gastonravindias/open-educational-ecg-data-logger/figures/Figure2_Revised_Hardware.png

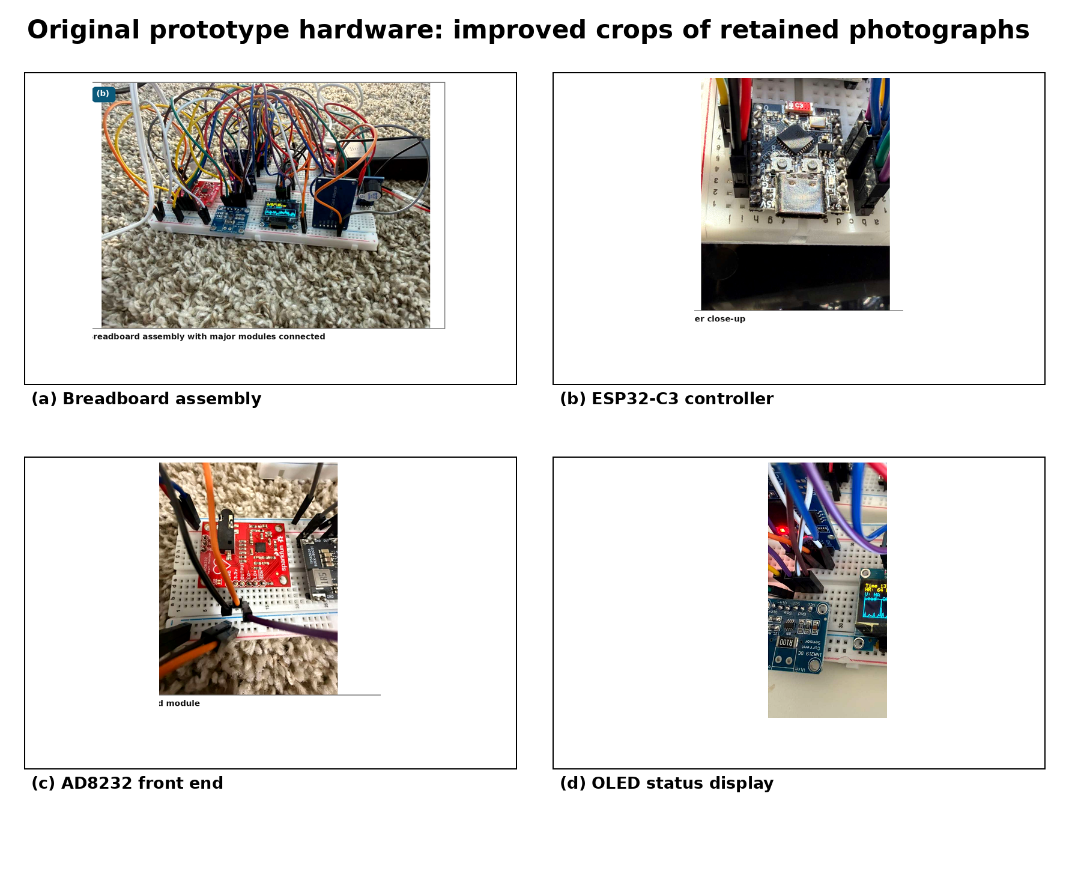
figures/Figure2_Revised_Hardware.png
