gastonravindias/open-educational-ecg-data-logger/media/serial_plotter_outputs.png

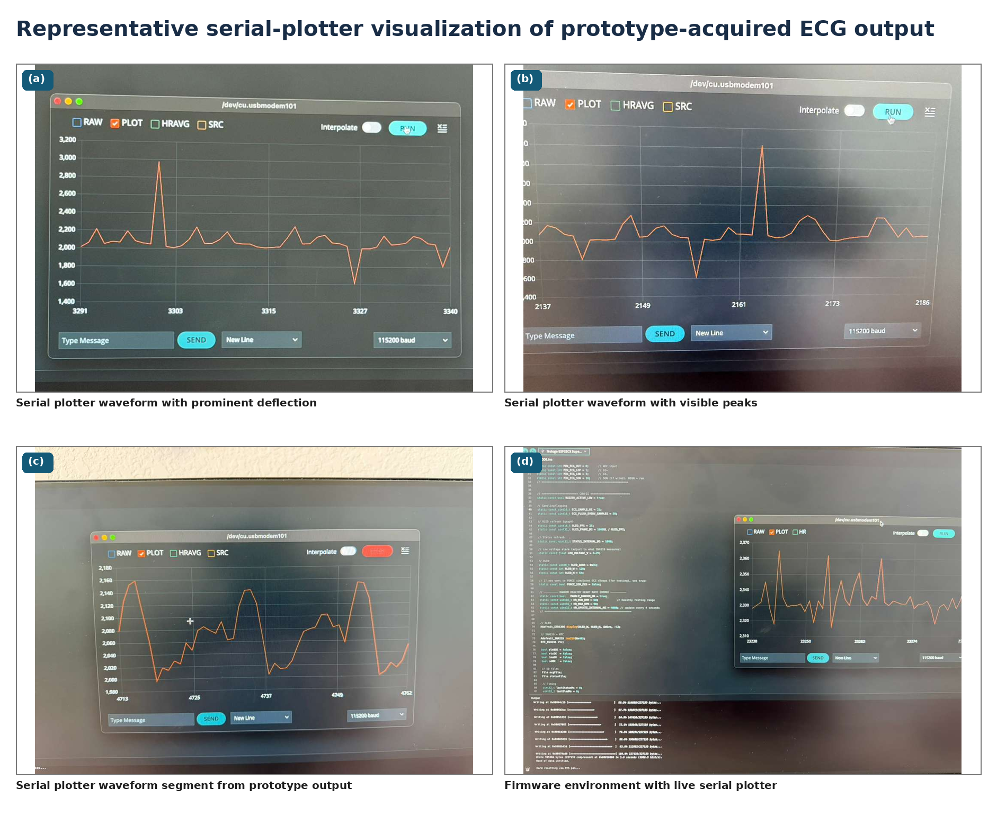
media/serial_plotter_outputs.png
