gastonravindias/open-educational-ecg-data-logger/figures/Figure1_Revised_Architecture.png

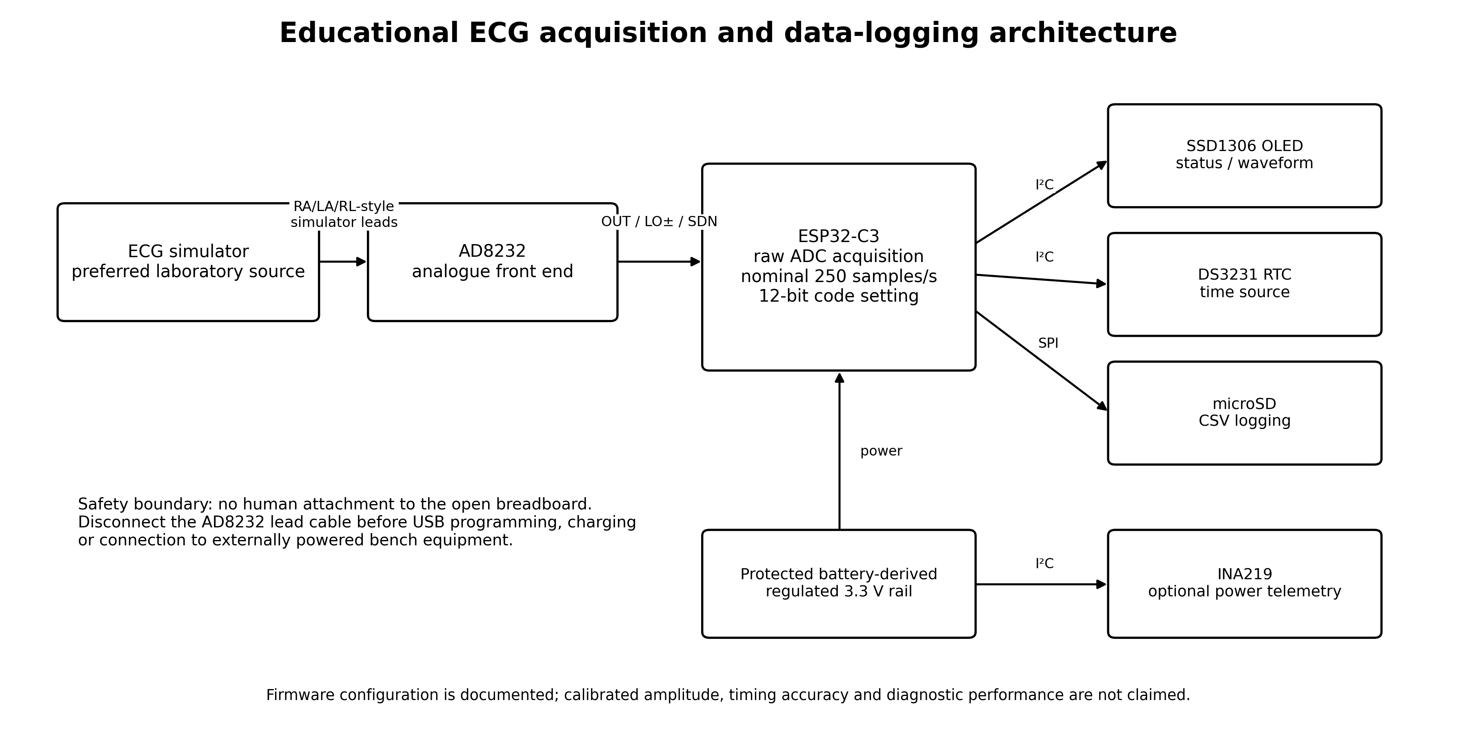
figures/Figure1_Revised_Architecture.png
