gastonravindias/open-educational-ecg-data-logger/figures/Figure3_Full_Connection_Diagram.png

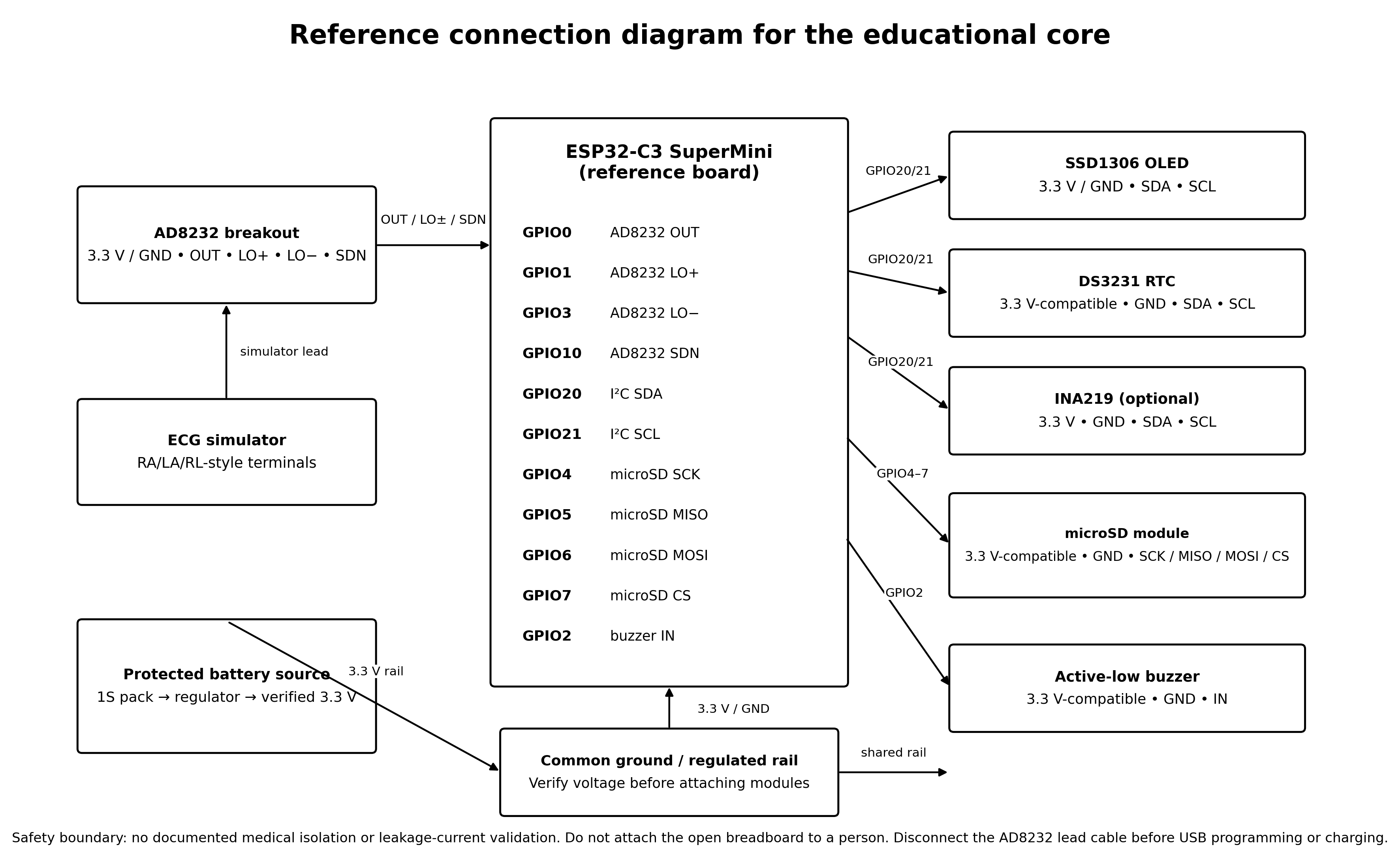
figures/Figure3_Full_Connection_Diagram.png
