gastonravindias/open-educational-ecg-data-logger/figures/Figure4_Revised_Waveform_Evidence.png

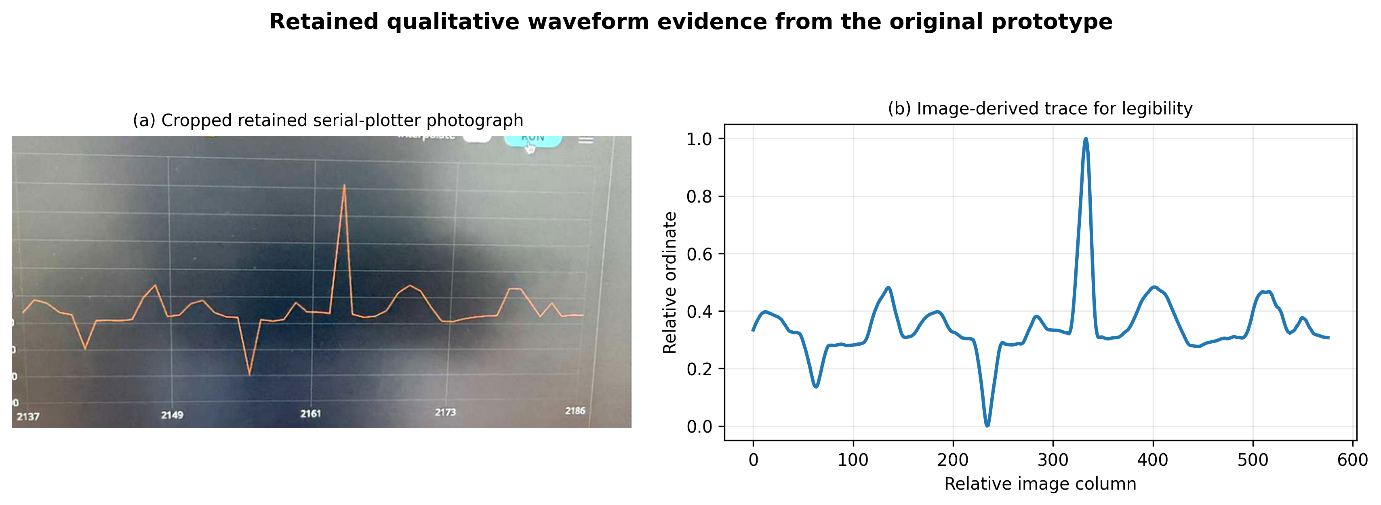
figures/Figure4_Revised_Waveform_Evidence.png
