gastonravindias/open-educational-ecg-data-logger/media/functional_evidence.png

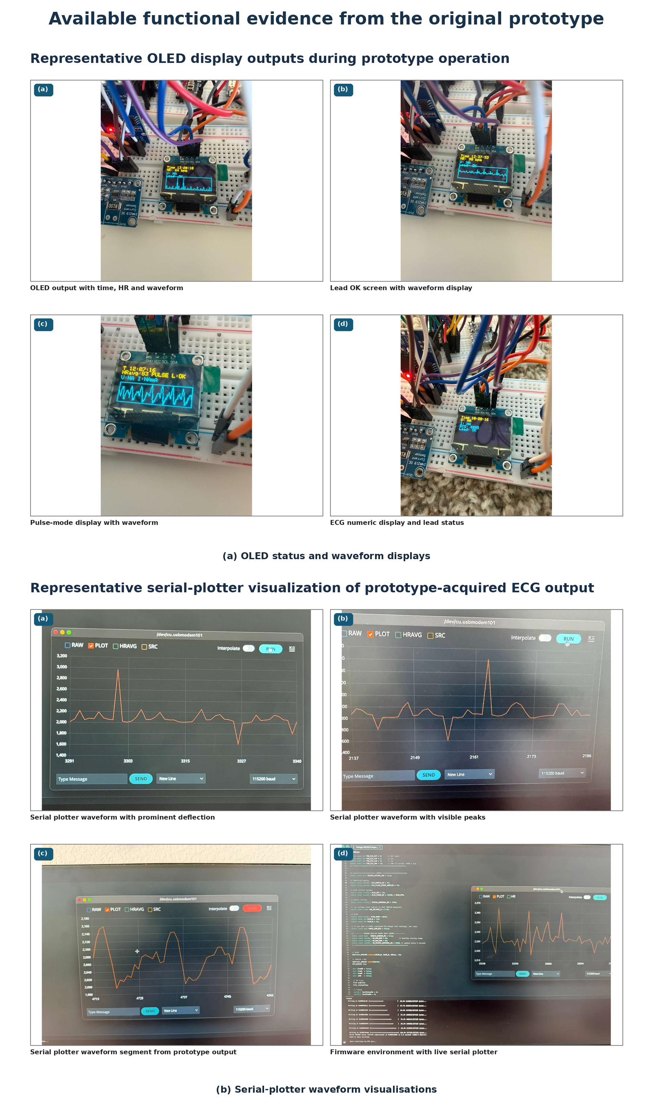
media/functional_evidence.png
