gastonravindias/open-educational-ecg-data-logger/REVIEW_REVISION_CHANGELOG.md

# Review Revision Changelog

## Reviewer B
Full connection/build guide; staged diagnostics; explicit ADC calibration boundary; simulator data-logging exercise; missing historical raw waveform data declared rather than reconstructed.

## Reviewer D
Comparison with representative systems; intended-user/prerequisite/supervision definition; concrete teaching scenarios; expanded BOM and power-source specification; solar removed from educational core; stronger safety; redrawn/improved figures.

## Reviewer E
FAIR/Data Accessibility statement; repository navigation; dependency/version documentation; ESP32-C3 raw-count and count-to-voltage clarification.
