gastonravindias/open-educational-ecg-data-logger/(commit log)

2026-07-17 Initial JOH Educational Hardware release v1.0.0
    [BOM.csv, available_evidence_matrix.csv, pin_map.csv, risk_assessment.csv]
2026-08-28 Add revised assembly guide for v1.1.0
2026-08-28 Add revised BOM for v1.1.0
    [BOM_v1_1.csv]
2026-08-28 Add revised editable wiring diagram for v1.1.0
2026-08-28 Add revised wiring diagram export for v1.1.0
2026-08-28 Update risk assessment for reviewer revision v1.1.0
    [risk_assessment.csv]
2026-08-28 Remove obsolete v1.0.0 assembly guide
2026-08-28 Remove obsolete v1.0.0 BOM
    [BOM.csv]
2026-08-28 Remove obsolete v1.0.0 wiring diagram
2026-08-28 Replace editable wiring diagram with final v1.1.0 version
2026-08-28 Remove obsolete v1.0.0 wiring export
2026-08-28 Replace wiring diagram export with final v1.1.0 version
2026-08-28 Remove superseded v1.0.0 prototype composite image
2026-08-28 Replace testing documentation with final v1.1.0 versions
    [available_evidence_matrix.csv]
2026-08-28 Replace assembly guide with final v1.1.0 version
2026-08-28 Replace BOM with final v1.1.0 version
    [BOM_v1_1.csv]
